h0lad/SolarMeshtasticNodeMini/pcb/components/steps/SW-TH_SSSS811101.step

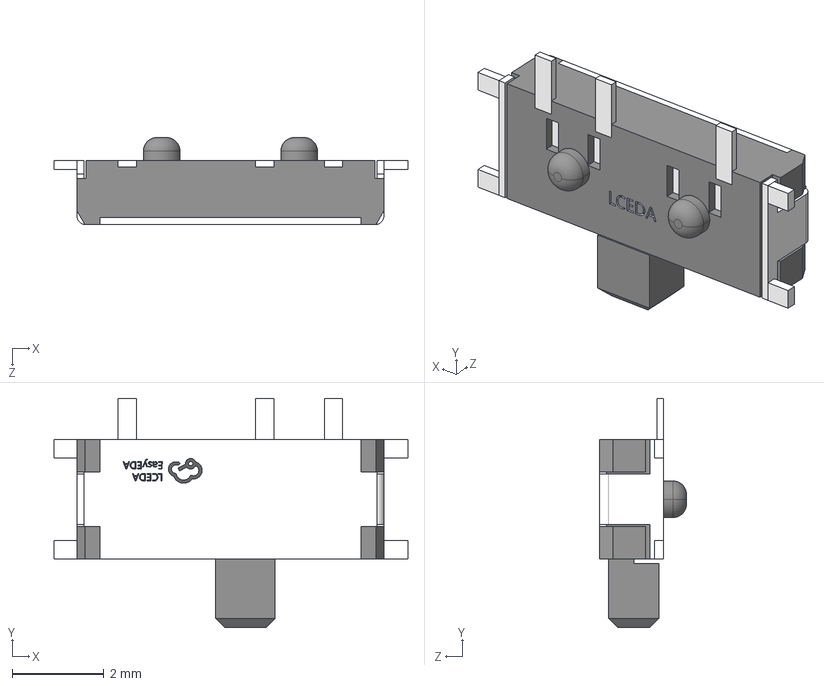
[picture p2: CAD file, 2026-08-01]
pcb/components/steps/SW-TH_SSSS811101.step
7.72 x 5.00 x 1.90 mm
