h0lad/SolarMeshtasticNodeMini/pcb/components/steps/heltecht62.step

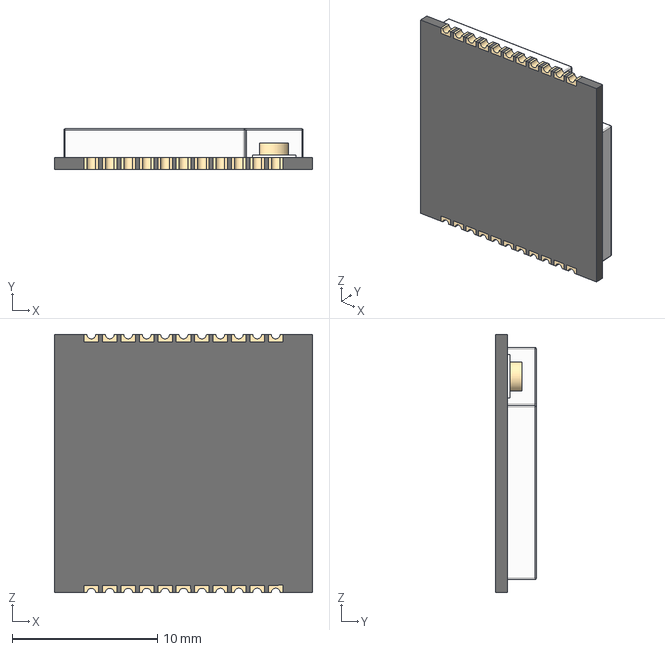
[picture p3: CAD file, 2026-01-08]
pcb/components/steps/heltecht62.step
17.8 x 2.80 x 17.8 mm
