h0lad/SolarMeshtasticNodeMini/pcb/SolarMeshtasticNodeMini.kicad_pcb

## KiCad design pcb/SolarMeshtasticNodeMini.kicad_pcb (2026-08-03)

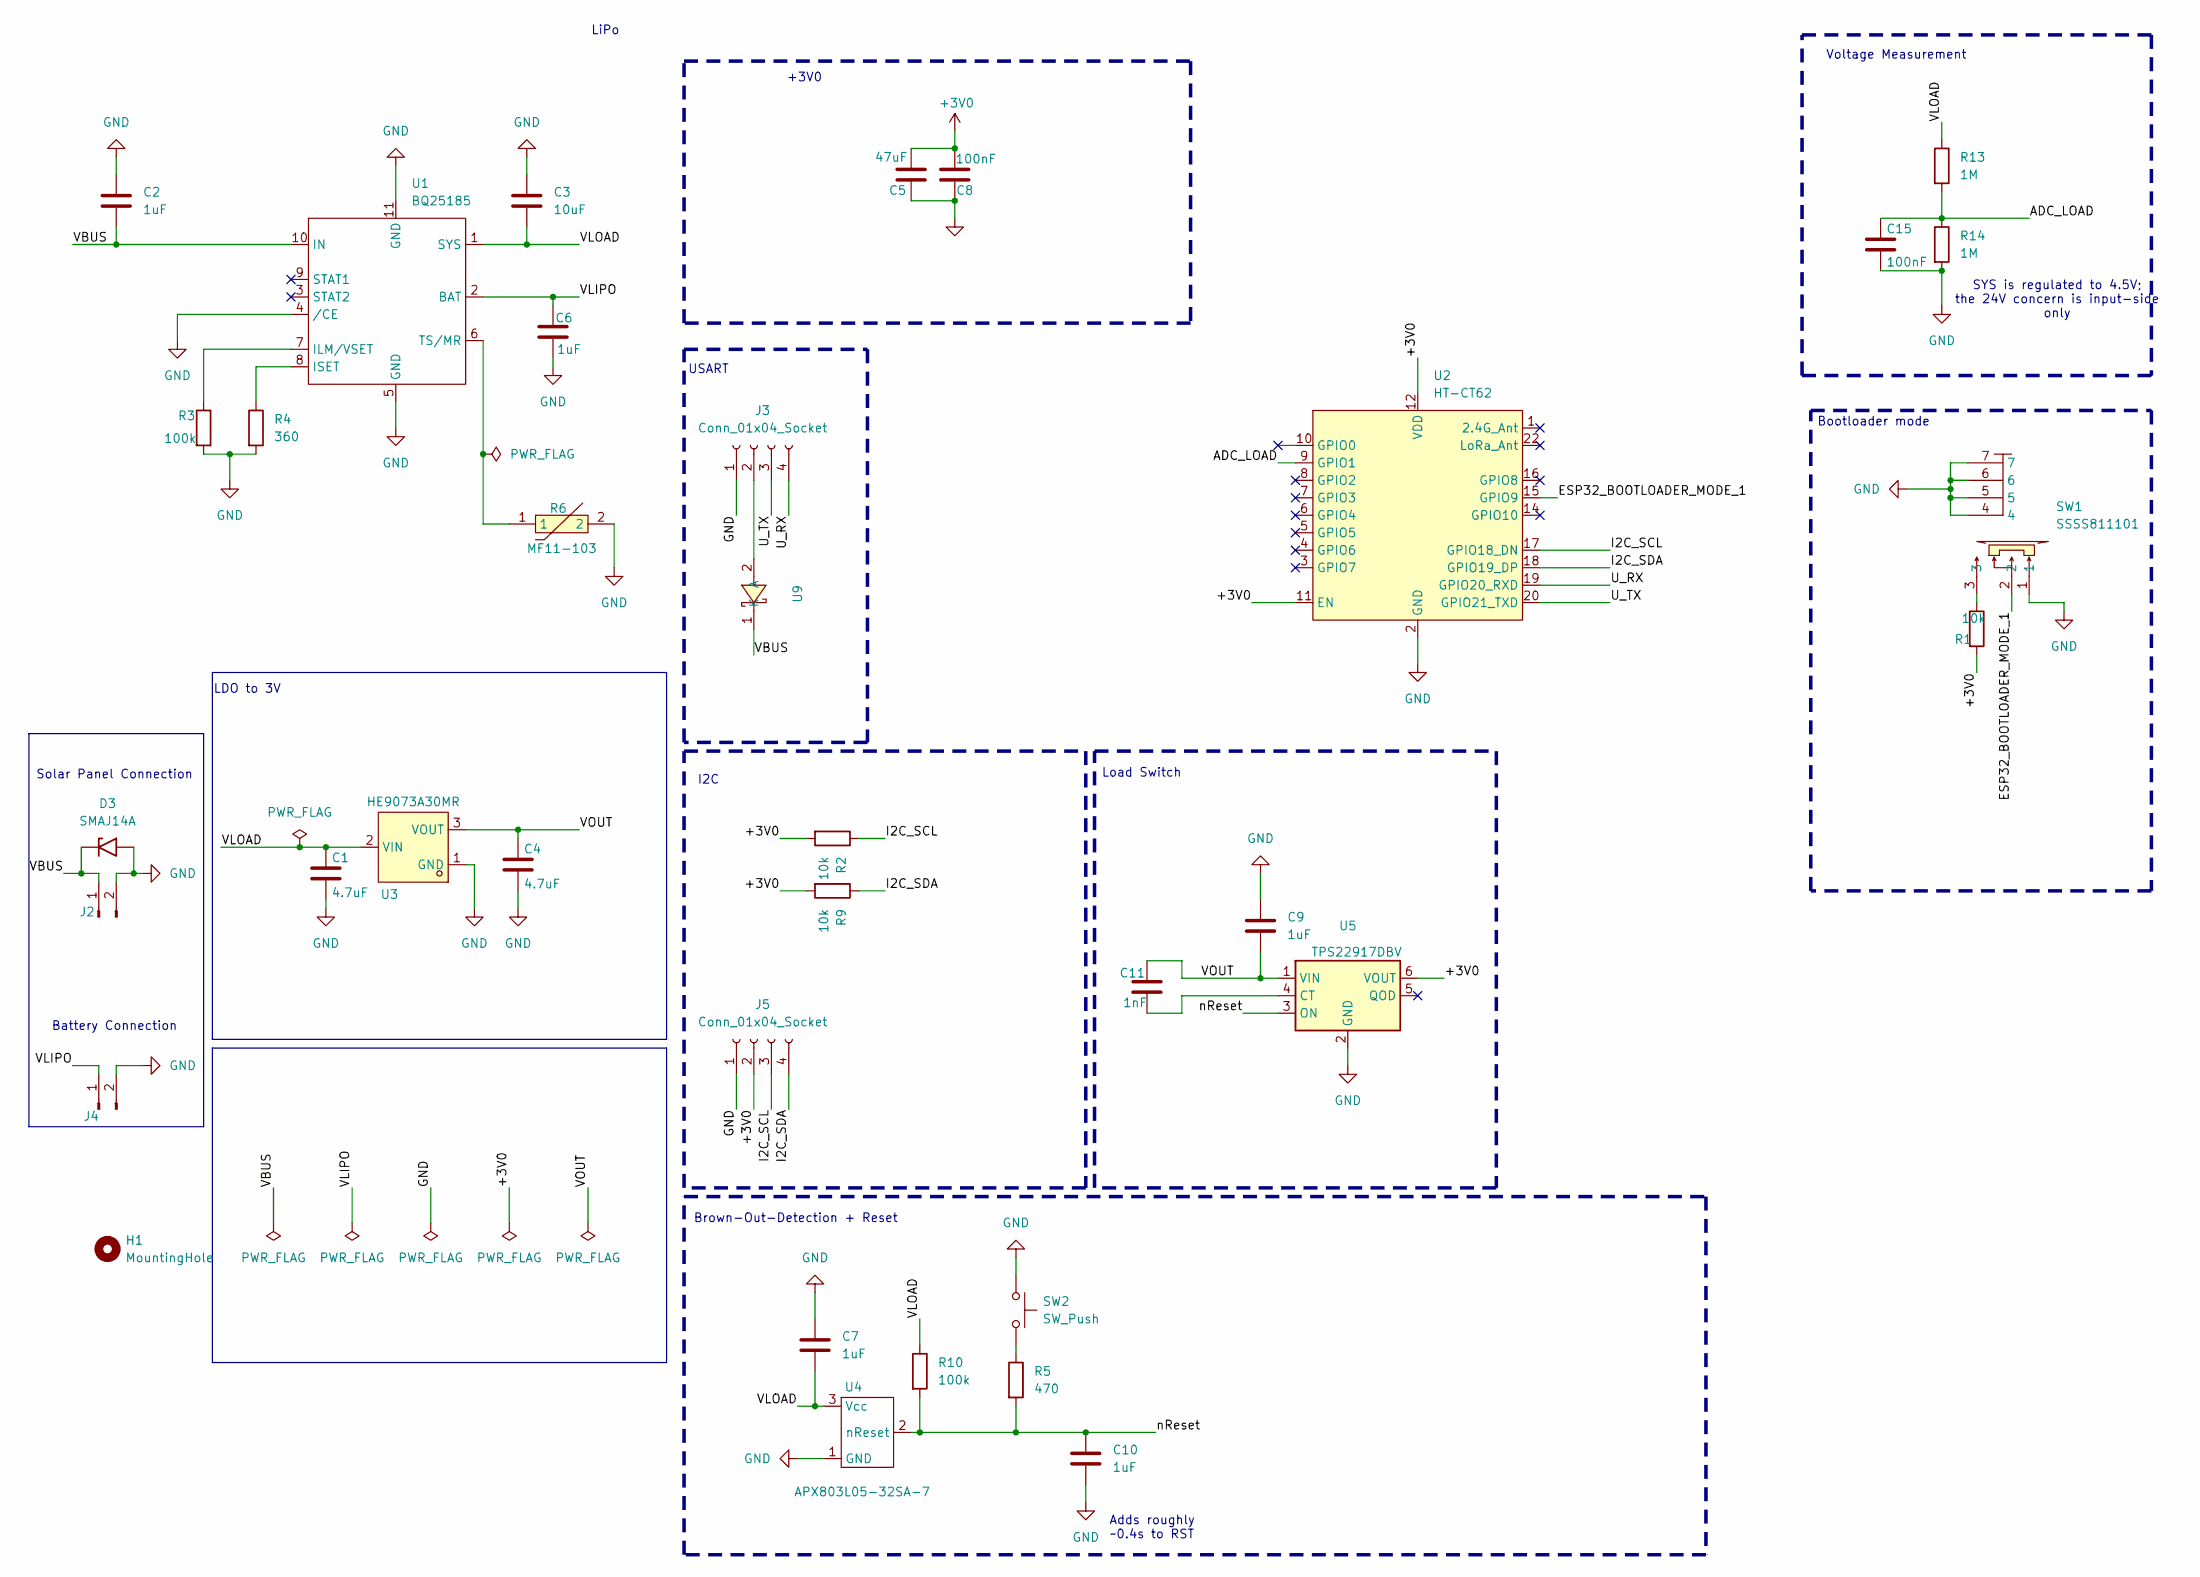
[picture p4: schematic SolarMeshtasticNodeMini.kicad_sch, SRCS]

Parts:
C1, C4: 4.7uF; C_0805_2012Metric_Pad1.18x1.45mm_HandSolder
C2, C6, C9, C10: 1uF; C_0805_2012Metric_Pad1.18x1.45mm_HandSolder
C3: 10uF; C_0805_2012Metric_Pad1.18x1.45mm_HandSolder
C5: 47uF; R_1206_3216Metric_Pad1.30x1.75mm_HandSolder
C7: 1uF; C_1206_3216Metric_Pad1.33x1.80mm_HandSolder
C8, C15: 100nF; C_0805_2012Metric_Pad1.18x1.45mm_HandSolder
C11: 1nF; C_0805_2012Metric_Pad1.18x1.45mm_HandSolder
D3: SMAJ14A; D_SMA
H1: MountingHole; MountingHole_2.7mm_M2.5_ISO7380
J2: Conn_01x02_Socket; JST_PH_B2B-PH-K_1x02_P2.00mm_Vertical
J3, J5: Conn_01x04_Socket; JST_PH_B4B-PH-K_1x04_P2.00mm_Vertical
J4: Conn_01x02_Pin; JST_PH_B2B-PH-K_1x02_P2.00mm_Vertical
R1, R2, R9: 10k; R_0805_2012Metric_Pad1.20x1.40mm_HandSolder
R3, R10: 100k; R_0805_2012Metric_Pad1.20x1.40mm_HandSolder
R4: 360; R_0805_2012Metric_Pad1.20x1.40mm_HandSolder
R5: 470; R_0805_2012Metric_Pad1.20x1.40mm_HandSolder
R6: MF11-103; R_0805_2012Metric_Pad1.20x1.40mm_HandSolder; LCSC Part C70913
R13, R14: 1M; R_0805_2012Metric_Pad1.20x1.40mm_HandSolder
SW1: SSSS811101; SW-SMD_SSSS811101; LCSC Part C109335
SW2: SW_Push; SMA_L4.3-W2.6-LS5.1-RD
U1: BQ25185; SON40P220X200X80-11N
U2: HT-CT62; Heltec_HT-CT62
U3: HE9073A30MR; SOT-23-3_L2.9-W1.6-P1.90-LS2.8-BR-CW; LCSC Part C723793
U4: APX803L05-32SA-7; SOT23-3
U5: TPS22917DBV; SOT-23-6
U9: SS26_C5350986; SMA_L4.3-W2.6-LS5.1-RD; LCSC Part C5350986

Connections:
+3V0: C5.2, C8.2, J5.2, R1.2, R2.2, R9.2, U2.11 (EN), U2.12 (VDD), U5.6 (VOUT)
/ADC_LOAD: C15.1, R13.2, R14.1, U2.9 (GPIO1)
/ESP32_BOOTLOADER_MODE_1: SW1.2, U2.15 (GPIO9)
/I2C_SCL: J5.3, R2.1, U2.17 (GPIO18_DN)
/I2C_SDA: J5.4, R9.1, U2.18 (GPIO19_DP)
/U_RX: J3.4, U2.19 (GPIO20_RXD)
/U_TX: J3.3, U2.20 (GPIO21_TXD)
/VBUS: C2.2, D3.1 (A1), J2.1, U1.10 (IN), U9.1 (K)
/VLIPO: C6.1, J4.1, U1.2 (BAT)
/VLOAD: C1.1, C3.2, C7.2, R10.1, R13.1, U1.1 (SYS), U3.2 (VIN), U4.3 (Vcc)
/VOUT: C4.1, C9.1, C11.1, U3.3 (VOUT), U5.1 (VIN)
/nReset: C10.2, R5.2, R10.2, U4.2 (nReset), U5.3 (ON)
GND: C1.2, C2.1, C3.1, C4.2, C5.1, C6.2, C7.1, C8.1, C9.2, C10.1, C15.2, D3.2 (A2), J2.2, J3.1, J4.2, J5.1, R3.2, R4.2, R6.2, R14.2, SW1.1, SW1.4, SW1.5, SW1.6, SW1.7, SW2.1, U1.4 (/CE), U1.5 (GND), U1.11 (GND), U2.2 (GND), U2.13 (GND), U2.21 (GND), U3.1 (GND), U4.1 (GND), U5.2 (GND)
unnamed: J3.2, U9.2 (A)
unnamed: R1.1, SW1.3
unnamed: R5.1, SW2.2
unnamed: R3.1, U1.7 (ILM/VSET)
unnamed: R4.1, U1.8 (ISET)
unnamed: R6.1, U1.6 (TS/MR)
unnamed: C11.2, U5.4 (CT)

Notes on the sheet:
Bootloader mode
Adds roughly ~0.4s to RST
USART
Voltage Measurement
LiPo
+3V0
Brown-Out-Detection + Reset
Solar Panel Connection
LDO to 3V
I2C
Battery Connection
SYS is regulated to 4.5V; the 24V concern is input-side only
Load Switch

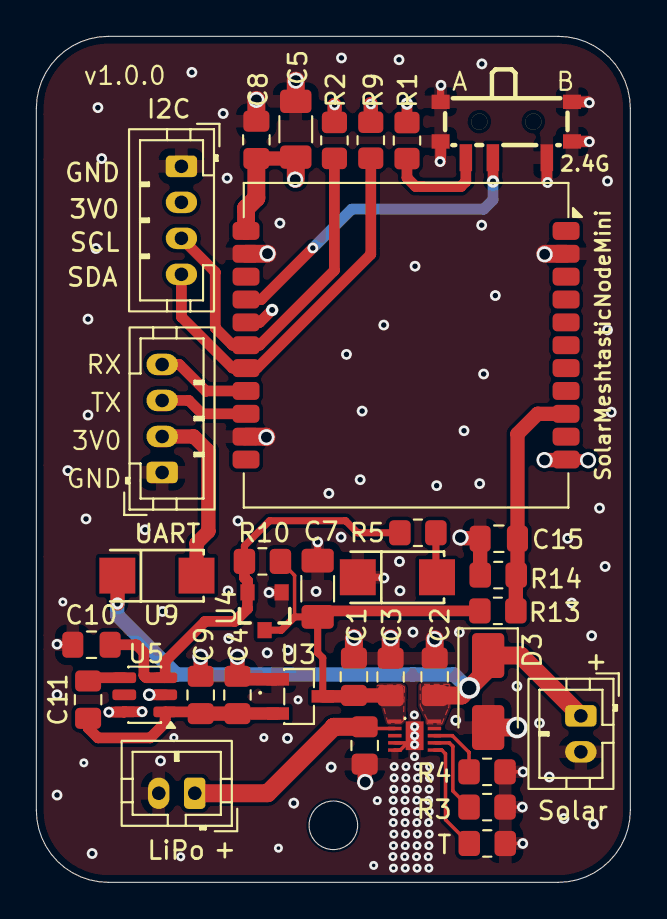
[picture p5: board SolarMeshtasticNodeMini.kicad_pcb from above]

Board: 4 copper layers, 33.0 x 47.0 mm, 36 parts (0 on the bottom side), 20 nets.
