h0lad/SolarMeshtasticNodeMini/(commit log)

2026-01-08 schematic: initial commit
    [BH-18650-PC.step, SolarMeshtasticNodeMini.kicad_pcb, SolarMeshtasticNodeMini.kicad_sch]
2026-01-08 pcb, sch: first layout done
    [BH-18650-PC.step, SolarMeshtasticNodeMini.kicad_pcb, SolarMeshtasticNodeMini.kicad_sch, heltecht62.step]
2026-01-08 pcb: fix some missing .steps and move silk prints around
    [SolarMeshtasticNodeMini.kicad_pcb]
2026-01-08 pcb, sch: use VLOAD and not VBUS for ADC
    [SolarMeshtasticNodeMini.kicad_pcb, SolarMeshtasticNodeMini.kicad_sch]
2026-01-08 pcb, jpg: small eyecandy works
    [SolarMeshtasticNodeMini.kicad_pcb]
2026-01-08 pcb: add missing silk prints
    [SolarMeshtasticNodeMini.kicad_pcb]
2026-01-10 pcb, sch: add mounting hole (M2.5)
    [SolarMeshtasticNodeMini.kicad_pcb, SolarMeshtasticNodeMini.kicad_sch]
2026-01-10 pcb, sch: other hole size and re-center
    [SolarMeshtasticNodeMini.kicad_pcb, SolarMeshtasticNodeMini.kicad_sch]
2026-01-11 pcb: mark 2.4GHz u.fl connector with a silk print
    [SolarMeshtasticNodeMini.kicad_pcb]
2026-01-11 README: be more precise about the though-hole connector
2026-01-11 pcb,sch: make the 3v3 of the bootloader switch weaker
    [SolarMeshtasticNodeMini.kicad_pcb, SolarMeshtasticNodeMini.kicad_sch]
2026-01-11 pcb: optimize 3v3 and gnd rails a bit
    [SolarMeshtasticNodeMini.kicad_pcb]
2026-01-16 pcb, sch: add load switch to control entire 3.3V rail
    Until now only the ESP32 was disabled if the voltage drops due to
    discharge. This might cause the sensors to slip into a slow brown-out.
    [SolarMeshtasticNodeMini.kicad_pcb, SolarMeshtasticNodeMini.kicad_sch]
2026-07-20 pcb, sch: move nRST pull-up R10 from +3V3 to /VOUT
    [SolarMeshtasticNodeMini.kicad_pcb, SolarMeshtasticNodeMini.kicad_sch]
2026-07-20 pcb, sch: add 1M:1M to the voltage divider
    [SolarMeshtasticNodeMini.kicad_sch]
2026-07-20 pcb, sch: pull GPIO8 to high - otherwise uart bootloader mode might be unreliable
    [SolarMeshtasticNodeMini.kicad_pcb, SolarMeshtasticNodeMini.kicad_sch]
2026-07-20 pcb, sch: add 10uF to nReset to slow down resets from 50ms to 0.4s
    [SolarMeshtasticNodeMini.kicad_pcb, SolarMeshtasticNodeMini.kicad_sch]
2026-07-20 pcb: improve via below bq25185
    [SolarMeshtasticNodeMini.kicad_pcb]
2026-07-20 pcb, sch: increase RISET from 300Ohm to 360OOhm as it was too close to the short-detect fault detection threshold
    [SolarMeshtasticNodeMini.kicad_pcb, SolarMeshtasticNodeMini.kicad_sch]
2026-07-20 pcb, doc: fix broken 3D renderings
    [SolarMeshtasticNodeMini.kicad_pcb]
2026-08-01 pcb, sch: add TVS protection to inputs
    [SW-TH_SSSS811101.step, SolarMeshtasticNodeMini.kicad_pcb, SolarMeshtasticNodeMini.kicad_sch]
2026-08-02 pcb, sch: we are using 3V0 everywhere. Also fix misleading comment in schematic regarding SYS voltage within the voltage divier
    [SolarMeshtasticNodeMini.kicad_pcb, SolarMeshtasticNodeMini.kicad_sch]
2026-08-02 pcb, sch: add 1nF C to power switch to limit inrush
    [SolarMeshtasticNodeMini.kicad_pcb, SolarMeshtasticNodeMini.kicad_sch]
2026-08-02 pcb, sch: remove tvs from VBat to avoid draining
    [SolarMeshtasticNodeMini.kicad_pcb, SolarMeshtasticNodeMini.kicad_sch]
2026-08-03 pcb, sch: GPIO is the NSS of the SX1262. Do not pull high.
    [SolarMeshtasticNodeMini.kicad_pcb, SolarMeshtasticNodeMini.kicad_sch]
